TolgaKarateke07/lucid-rem-mask/hardware/schematic.pdf

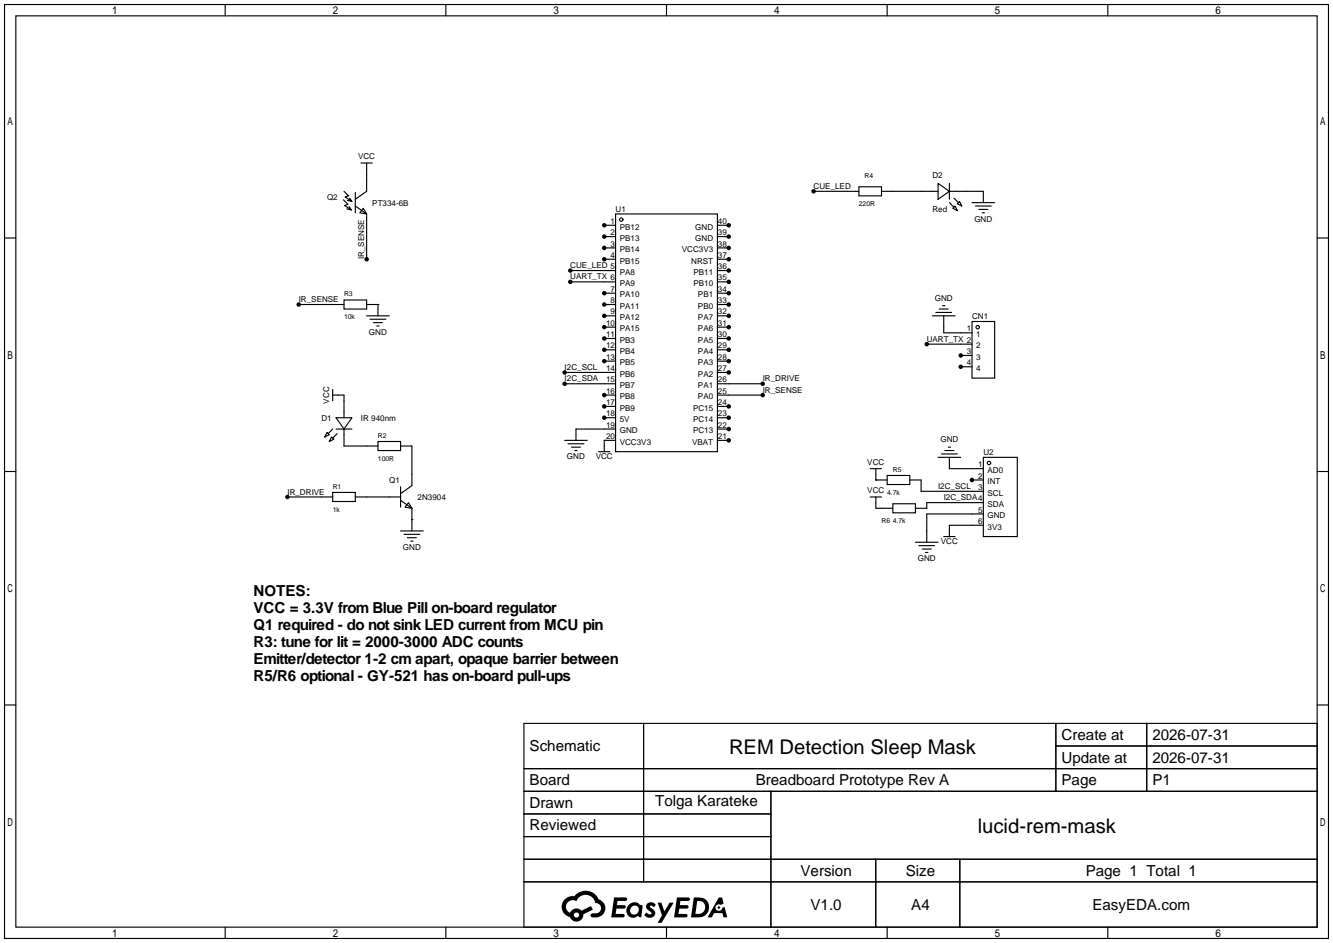
[picture p4: page 1]

NOTES:
VCC = 3.3V from Blue Pill on-board regulator
Q1 required - do not sink LED current from MCU pin
R3: tune for lit = 2000-3000 ADC counts
Emitter/detector 1-2 cm apart, opaque barrier between
R5/R6 optional - GY-521 has on-board pull-ups

Schematic | REM Detection Sleep Mask | Create at | 2026-07-31

Update at | 2026-07-31

Board | Breadboard Prototype Rev A | Page | P1
Drawn | Tolga Karateke | lucid-rem-mask
Reviewed

Version | Size | Page 1 Total 1
V1.0 | A4 | EasyEDA.com
